ChloeLarroze/IOT_Project_OCASS/Core/Src/main.c

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
/* Includes ------------------------------------------------------------------*/
#include "main.h"
#include "adc.h"
#include "spi.h"
#include "tim.h"
#include "usart.h"
#include "gpio.h"

/* USER CODE BEGIN Includes */
#include "debug.h"
#include "hal.h"
#include "lmic.h"
#include "lorabase.h"
#include "oslmic.h"
#include "cayenne_lpp.h"

/* USER CODE END Includes */


/* USER CODE BEGIN PV */

// application router ID (LSBF) < ------- IMPORTANT
static const u1_t APPEUI[8] = {0x26, 0x41, 0x85, 0x75, 0x47, 0x65, 0x32, 0x72};
//old { 0x00, 0x00, 0x00, 0x00, 0x00, 0x00, 0x00, 0x00 };//IMPORT FROM TTN

// unique device ID (LSBF) < ------- IMPORTANT
static const u1_t DEVEUI[8] = {0xAC, 0xCE, 0x06, 0xD0, 0x7E, 0xD5, 0xB3, 0x70};
//old { 0x7F, 0xCB, 0x06, 0xD0, 0x7E, 0xD5, 0xB3, 0x70 };//CREATE RANDOM NUMBER

// device-specific AES key (derived from device EUI (MSBF))
static const u1_t DEVKEY[16] = {0x4D, 0x55, 0xCE, 0x1B, 0x4D, 0x7F, 0x01, 0x3B, 0x8A, 0x98, 0x6F, 0xDB, 0x04, 0x24, 0x8D, 0xD1};
//old { 0x25, 0x00, 0x7B, 0x76, 0x3D, 0x5C, 0xD4, 0x28, 0x3D, 0xA6, 0x0B, 0x9A, 0xDA, 0x61, 0x48, 0x7E };//IMPORT FROM TTN


//APPEUI,DEVEUI must be copied from thethingsnetwork application datas in LSB format
//-----------------------------------------------------------------------------------------
/* USER CODE END PV */

void SystemClock_Config(void);
/* USER CODE BEGIN 0 */
// provide application router ID (8 bytes, LSBF)
void os_getArtEui (u1_t* buf) {
	memcpy(buf, APPEUI, 8);
}
// provide device ID (8 bytes, LSBF)
void os_getDevEui (u1_t* buf) {
	memcpy(buf, DEVEUI, 8);
}
// provide device key (16 bytes)
void os_getDevKey (u1_t* buf) {
	memcpy(buf, DEVKEY, 16);
}
void initsensor(){
// Here you init your sensors
	HAL_ADCEx_Calibration_Start(&hadc1, ADC_SINGLE_ENDED);
}

void initfunc (osjob_t* j) {
	// intialize sensor hardware
	initsensor();
	// reset MAC state
	LMIC_reset();
	// start joining
	LMIC_startJoining();
	// init done - onEvent() callback will be invoked...
}

uint32_t get_ADC_value(ADC_HandleTypeDef hadc1, uint32_t channel)
{
	uint32_t adc_val = 0;
	HAL_ADCEx_Calibration_Start(&hadc1, ADC_SINGLE_ENDED);
	HAL_ADC_Start(&hadc1);
	HAL_ADC_PollForConversion(&hadc1, 100);
	adc_val = HAL_ADC_GetValue(&hadc1);
	return adc_val;
}
float GET_temperature(uint32_t ADC_value, double VDD){
	float TEMP_value = 0.0;
	float voltage = 0.0;
	// ADC value conversion into the corresponding voltage in Volts
	// voltage = (ADC_value*VDD) /4095.0; // Float => Volts
	voltage = (ADC_value*VDD)/4095; // Int => Volts
	debug_int(voltage);
	debug_str("\r\n");

	// Temperature computing in °C
	// TEMP_value = ( (50.0-(-10.0))/(0.760-1.088)) *(voltage-1.088) *(voltage-1.088)+(-10.0) ;
	TEMP_value = (1034-voltage)/5.48;
	return TEMP_value;
}
float readtemperaturesensor(){
	//Il faut alimenter le capteur

	HAL_GPIO_WritePin(Alim_temp_GPIO_Port, Alim_temp_Pin, GPIO_PIN_SET);
	HAL_Delay(100);
	uint value = 0xDF; /// read from evrything ...make your own sensor
	HAL_ADC_Start(&hadc1);
	value = get_ADC_value(hadc1, ADC_CHANNEL_15);
	debug_str("Brut value:\n");
	debug_int(value);
	debug_str("\r\n");
	float temperature_sensor_value = GET_temperature(value, 3300);
	debug_valfloat("Temperature sensor value = ", temperature_sensor_value, 6);//6 doit etre le nbr de chiffres après la ,
	//On éteint le capteur
	HAL_GPIO_WritePin(Alim_temp_GPIO_Port, Alim_temp_Pin, GPIO_PIN_RESET);
	return temperature_sensor_value;
}


u2_t readsensor(){
	u2_t value = 0xDF; /// read from evrything ...make your own sensor
	return value;
}

static osjob_t reportjob;
// report sensor value every minute
static void reportfunc (osjob_t* j) {
	cayenne_lpp_t lpp = {0};

	// read sensor
	debug_str("Read Temperature Sensor\n");
	float valuereport = readtemperaturesensor();
	debug_valfloat("val = ", valuereport, 6);
	// prepare and schedule data for transmission
	cayenne_lpp_reset(&lpp);
	cayenne_lpp_add_temperature(&lpp, 0, valuereport);

	LMIC_setTxData2(1, &lpp, 4, 0);

	/*LMIC.frame[0] = 0;//val << 8;//pas dans le mm sens que sur le diapo
	LMIC.frame[1] = 0x67;//val;
	valuereport = valuereport/100;
	LMIC.frame[2] = valuereport>>8;
	LMIC.frame[3] = valuereport;
	LMIC_setTxData2(1, LMIC.frame, 2, 0);*/
	// (port 1, 2 bytes, unconfirmed)
	// reschedule job in 60 seconds
	os_setTimedCallback(j, os_getTime()+sec2osticks(2), reportfunc);
}


// counter
static int cnt = 0;
static osjob_t hellojob;
static void hellofunc (osjob_t* j) {
	// say hello
	debug_str("Hello World!\r\n");
	// log counter
	debug_val("cnt = ", cnt);
	// toggle LED
	debug_led (++cnt & 1);
	// reschedule job every second
	os_setTimedCallback(j, os_getTime()+sec2osticks(1), hellofunc);//TODO : Demander à Bernier
}

static osjob_t blinkjob;
static u1_t ledstate = 0;
static void blinkfunc (osjob_t* j) {
// toggle LED
ledstate = !ledstate;
debug_led (ledstate);
// reschedule blink job
os_setTimedCallback(j, os_getTime()+ms2osticks(1000), blinkfunc);
}


//////////////////////////////////////////////////
// LMIC EVENT CALLBACK
//////////////////////////////////////////////////
void onEvent (ev_t ev) {
	debug_event(ev);
	switch(ev) {
	// network joined, session established
		case EV_JOINING:
			debug_str("try joining\r\n");
			blinkfunc(&blinkjob);
			break;
		case EV_JOINED:
			// kick-off periodic sensor job
			debug_str("Joined\r\n");
			os_clearCallback(&blinkjob);
			debug_led (1);
			reportfunc(&reportjob);
			break;
		case EV_JOIN_FAILED:
			debug_str("join failed\r\n");
			break;
		case EV_SCAN_TIMEOUT:
			debug_str("EV_SCAN_TIMEOUT\r\n");
			break;
		case EV_BEACON_FOUND:
			debug_str("EV_BEACON_FOUND\r\n");
			break;
		case EV_BEACON_MISSED:
			debug_str("EV_BEACON_MISSED\r\n");
			break;
		case EV_BEACON_TRACKED:
			debug_str("EV_BEACON_TRACKED\r\n");
			break;
		case EV_RFU1:
			debug_str("EV_RFU1\r\n");
			break;
		case EV_REJOIN_FAILED:
			debug_str("EV_REJOIN_FAILED\r\n");
			break;
		case EV_TXCOMPLETE:
			debug_str("EV_TXCOMPLETE (includes waiting for RX windows)\r\n");
			if (LMIC.txrxFlags & TXRX_ACK)
				debug_str("Received ack\r\n");
			if (LMIC.dataLen) {
				debug_str("Received ");
				debug_str(LMIC.dataLen);
				debug_str(" bytes of payload\r\n");
			}
			break;
		case EV_LOST_TSYNC:
			debug_str("EV_LOST_TSYNC\r\n");
			break;
		case EV_RESET:
			debug_str("EV_RESET\r\n");
			break;
		case EV_RXCOMPLETE:
			// data received in ping slot
			debug_str("EV_RXCOMPLETE\r\n");
			break;
		case EV_LINK_DEAD:
			debug_str("EV_LINK_DEAD\r\n");
			break;
		case EV_LINK_ALIVE:
			debug_str("EV_LINK_ALIVE\r\n");
			break;
		default:
			debug_str("Unknown event\r\n");
			break;
	}
}


/* USER CODE END 0 */

/**
  * @brief  The application entry point.
  * @retval int
  */
int main(void)
{

  /* MCU Configuration--------------------------------------------------------*/

  /* Reset of all peripherals, Initializes the Flash interface and the Systick. */
  HAL_Init();

  /* Configure the system clock */
  SystemClock_Config();

  /* Initialize all configured peripherals */
  MX_GPIO_Init();
  MX_ADC1_Init();
  MX_SPI3_Init();
  MX_TIM7_Init();
  MX_USART1_UART_Init();
  /* USER CODE BEGIN 2 */
  HAL_TIM_Base_Start_IT(&htim7);   // <----------- change to your setup
  __HAL_SPI_ENABLE(&hspi3);        // <----------- change to your setup
  osjob_t initjob;
  // initialize runtime env
  os_init();
  // initialize debug library
  debug_init();
  // setup initial job
  //os_setCallback(&hellojob, hellofunc);   //slide 56 and 57
  os_setCallback(&initjob, initfunc);//Pour tester le capteur de temp on rajoute
  //os_setCallback(&reportjob, reportfunc);
  // execute scheduled jobs and events
  os_runloop();
  // (not reached)
  return 0;
  /* USER CODE END 2 */

  /* Infinite loop */
  /* USER CODE BEGIN WHILE */
  while (1)//On y rentre jamais
  {
    /* USER CODE END WHILE */

    /* USER CODE BEGIN 3 */
  }
  /* USER CODE END 3 */
}

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
