ChloeLarroze/IOT_Project_OCASS/IOT_Project_OCASS.ioc

Mcu.UserName=STM32L432KCUx
PA10.Signal=USART1_RX
PA11.GPIO_Label=RST
PA11.Signal=GPIO_Output
PA7.GPIO_Label=Alim_temp
PA7.Signal=GPIO_Output
PA9.Signal=USART1_TX
PB0.GPIO_Label=TEMP
PB0.Signal=ADCx_IN15
PB1.GPIO_Label=LED
PB1.Signal=GPIO_Output
PB5.Signal=SPI3_MOSI
PB6.GPIO_Label=DIO0
PB6.Signal=GPXTI6
PB7.GPIO_Label=DIO1
PB7.Signal=GPXTI7
