ChloeLarroze/IOT_Project_OCASS/(commit log)

2024-12-03 Led is blinking
    Slide 56 complete
2024-12-10 JOIN done, Uplink : work in progress
    We are working on slide 65. We haven't the correct operations (we go in UNKNOW EVENT instead of JOINED)
    [lmic.c, main.c]
2024-12-17 Temperature Sensor working with loop
    Lora not testable; Temperature Sensor working
2025-01-08 Lora work temperature not coherent
2025-01-08 temperature sensor perfect
    temperature sensor working correctly with transmission and without offset
    [main.c]
